rkourdis/rpi_spi_uart_pcb/spi_pcb.kicad_pcb

## KiCad design spi_pcb.kicad_pcb (2025-06-19)

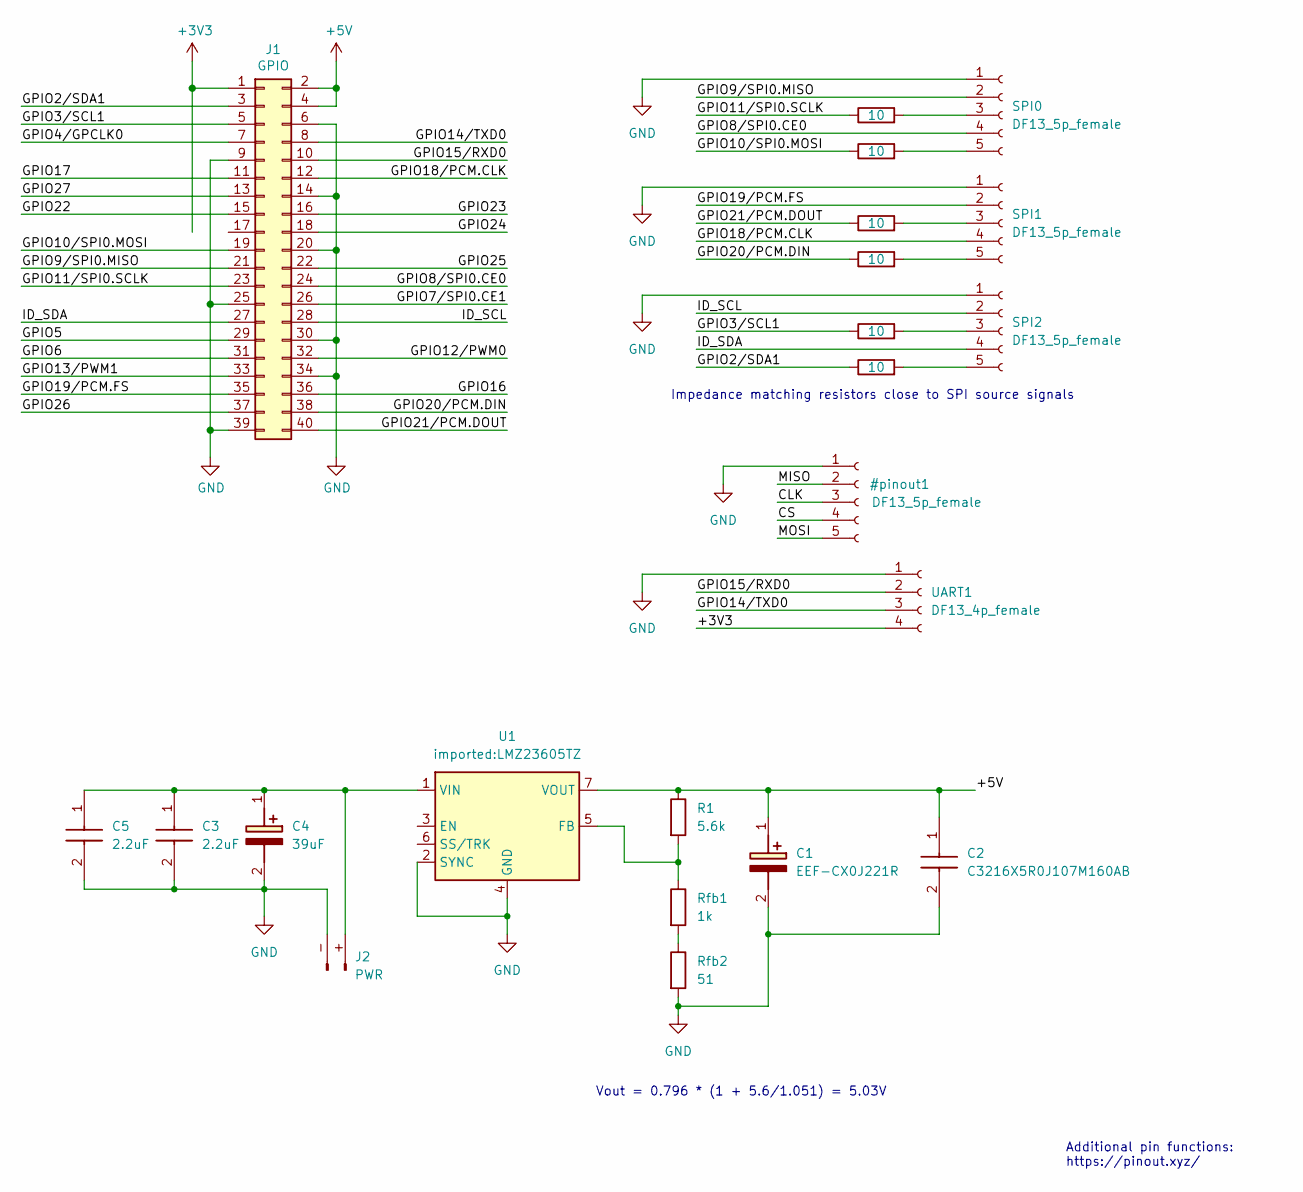
[picture p1: schematic spi_pcb.kicad_sch]

Parts:
C1: EEF-CX0J221R; EEFCX0J101R; Mouser Part Number 667-EEF-CX0J221R
C2: C3216X5R0J107M160AB; CAPC3216X180N; Mouser Part Number 810-C3216X5R0J107M
C3, C5: 2.2uF; CAPC1608X90N; Mouser Part Number 81-GRT188R61H225KE3D
C4: 39uF; 16SVPT560M; Manufacturer_Part_Number 50SVPF39M; Mouser Part Number 667-50SVPF39M
J1: GPIO; PinSocket_2x20_P2.54mm_Vertical
J2: PWR; AMASS_XT30PW-M_1x02_P2.50mm_Horizontal
R1: 5.6k; R_0603_1608Metric
R3, R4, R5, R6, R7, R8: 10; R_0402_1005Metric_Pad0.72x0.64mm_HandSolder
Rfb1: 1k; R_0603_1608Metric
Rfb2: 51; R_0603_1608Metric
SPI0, SPI1, SPI2: DF13_5p_female; Hirose_DF13-05P-1.25DS_1x05_P1.25mm_Horizontal
U1: imported:LMZ23605TZ; Texas_NDW-7_TabPin4
UART1: DF13_4p_female; Hirose_DF13-04P-1.25DS_1x04_P1.25mm_Horizontal

Connections:
+3V3: J1.1, UART1.4
+5V: C1.1 (+), C2.1, J1.2, J1.4, R1.1, U1.7 (VOUT)
/GPIO2/SDA1: J1.3, R8.1
/GPIO3/SCL1: J1.5, R7.1
/GPIO4/GPCLK0: J1.7
/GPIO5: J1.29
/GPIO6: J1.31
/GPIO7/SPI0.CE1: J1.26
/GPIO8/SPI0.CE0: J1.24, SPI0.4
/GPIO9/SPI0.MISO: J1.21, SPI0.2
/GPIO10/SPI0.MOSI: J1.19, R4.1
/GPIO11/SPI0.SCLK: J1.23, R3.1
/GPIO12/PWM0: J1.32
/GPIO13/PWM1: J1.33
/GPIO14/TXD0: J1.8, UART1.3
/GPIO15/RXD0: J1.10, UART1.2
/GPIO16: J1.36
/GPIO17: J1.11
/GPIO18/PCM.CLK: J1.12, SPI1.4
/GPIO19/PCM.FS: J1.35, SPI1.2
/GPIO20/PCM.DIN: J1.38, R5.1
/GPIO21/PCM.DOUT: J1.40, R6.1
/GPIO22: J1.15
/GPIO23: J1.16
/GPIO24: J1.18
/GPIO25: J1.22
/GPIO26: J1.37
/GPIO27: J1.13
/ID_SCL: J1.28, SPI2.2
/ID_SDA: J1.27, SPI2.4
GND: C1.2 (-), C2.2, C3.2, C4.2 (-), C5.2, J1.6, J1.9, J1.14, J1.20, J1.25, J1.30, J1.34, J1.39, J2.- (Pin_1), Rfb2.2, SPI0.1, SPI1.1, SPI2.1, U1.2 (SYNC), U1.4 (GND), UART1.1
unnamed: C3.1, C4.1 (+), C5.1, J2.+ (Pin_2), U1.1 (VIN)
unnamed: Rfb1.2, Rfb2.1
unnamed: R3.2, SPI0.3
unnamed: R4.2, SPI0.5
unnamed: R6.2, SPI1.3
unnamed: R5.2, SPI1.5
unnamed: R7.2, SPI2.3
unnamed: R8.2, SPI2.5
unnamed: R1.2, Rfb1.1, U1.5 (FB)

Notes on the sheet:
Additional pin functions: https://pinout.xyz/
Impedance matching resistors close to SPI source signals
Vout = 0.796 * (1 + 5.6/1.051) = 5.03V

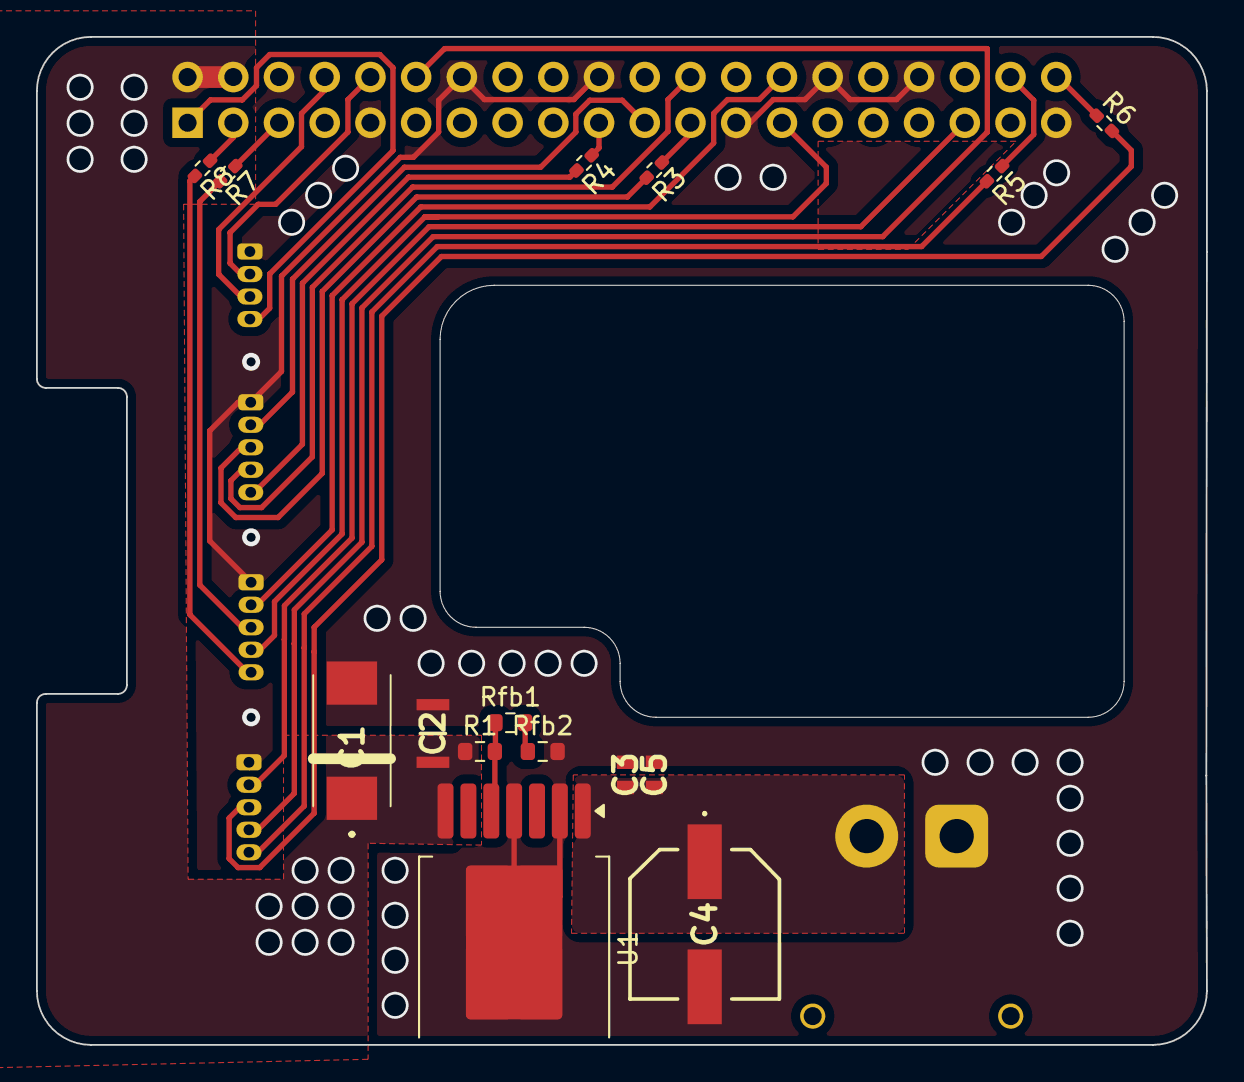
[picture p2: board spi_pcb.kicad_pcb from above]

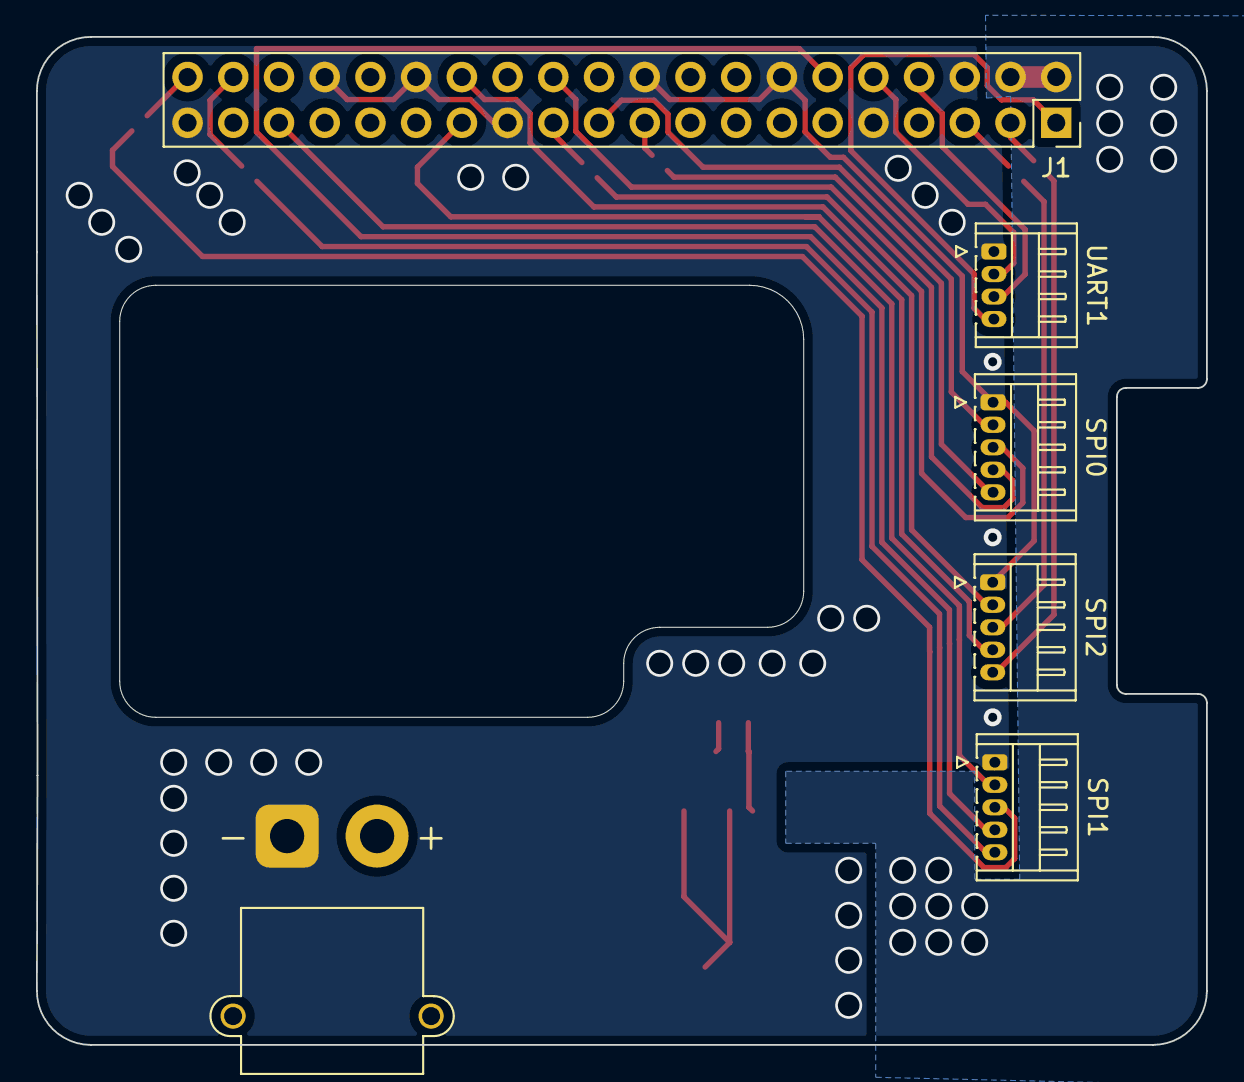
[picture p3: board spi_pcb.kicad_pcb from below]

Board: 2 copper layers, 65.0 x 56.0 mm, 21 parts (6 on the bottom side), 26 nets.
