rkourdis/rpi_spi_uart_pcb/(commit log)

2025-06-18 Sent connectors to back plane
    [spi_pcb.kicad_pcb, spi_pcb.kicad_sch]
2025-06-18 Add copper pours, cooling cutout and correct vias.
    [spi_pcb.kicad_pcb]
2025-06-18 Correct schematic annotations
    [spi_pcb.kicad_sch]
2025-06-19 Added VCC ceramic filter caps
    [spi_pcb.kicad_pcb, spi_pcb.kicad_sch]
2025-06-19 Rerouted for 0.25mm copper clearance. Added sample SPI impedance matching resistor.
    [spi_pcb.kicad_pcb, spi_pcb.kicad_sch]
2025-06-19 Cut cooling hole for Raspberry CPU, redone vias. Added 10 Ohm impedance matching for source SPI signals.
    [spi_pcb.kicad_pcb, spi_pcb.kicad_sch]
2025-06-19 Fill all areas with copper to reduce CNC time.
    [spi_pcb.kicad_pcb]
2025-06-19 Move power connector a bit closer to centre. Add project library.
    [spi_pcb.kicad_pcb, spi_pcb.kicad_sch]
2025-06-19 Split feedback resistors into available values.
    [spi_pcb.kicad_pcb, spi_pcb.kicad_sch]
2025-06-19 Increased via diameter to allow for wire soldering.
    [spi_pcb.kicad_pcb]
2025-06-20 Add information to schematic
    [spi_pcb.kicad_sch]
